robinmonsere/GIP_RM_2020-2021/GIP_RM_Documentatie/GIP presentation.pptx

## GIP presentation

The pinball machine by Robin monsere

## 2 parts

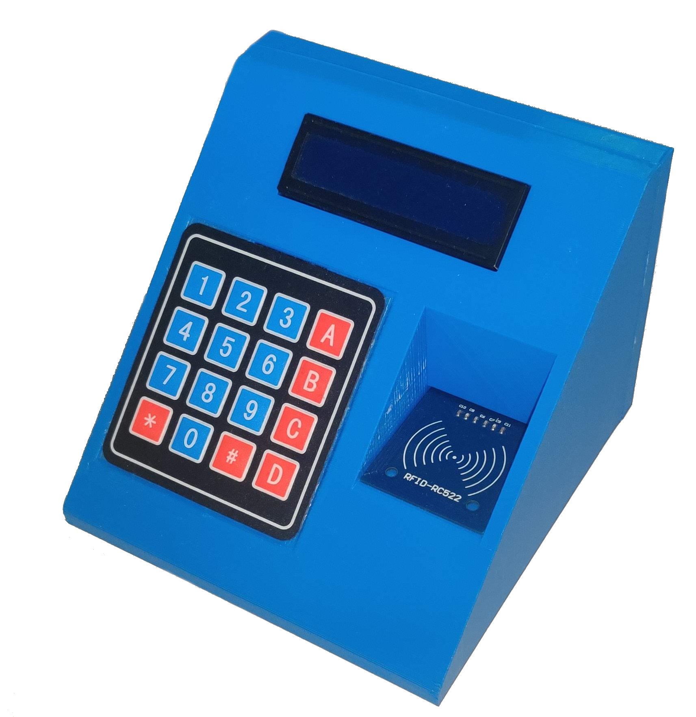
[picture p31: figure]

## No external partner/company

- Had a lot of ideas
- Has electronics/software/moving parts
- Wanted to learn RFID

## How? – 3D printing

- Sketches
- 3D drawing
- Printing

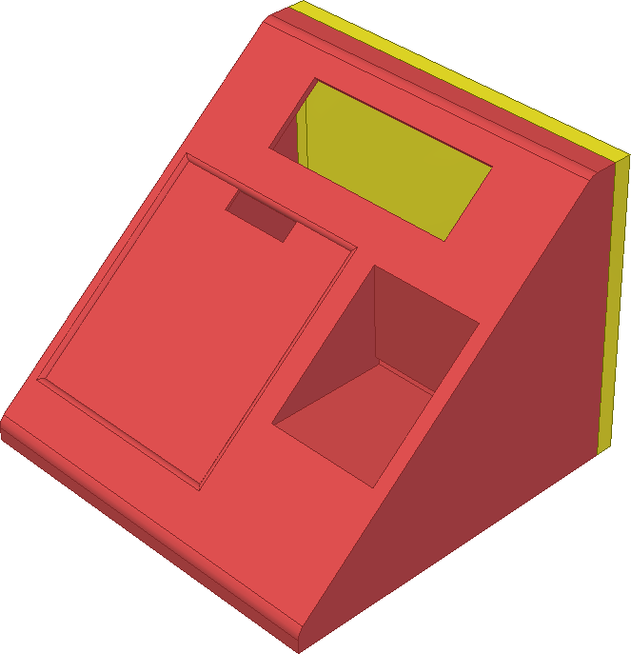
[picture p32: figure]
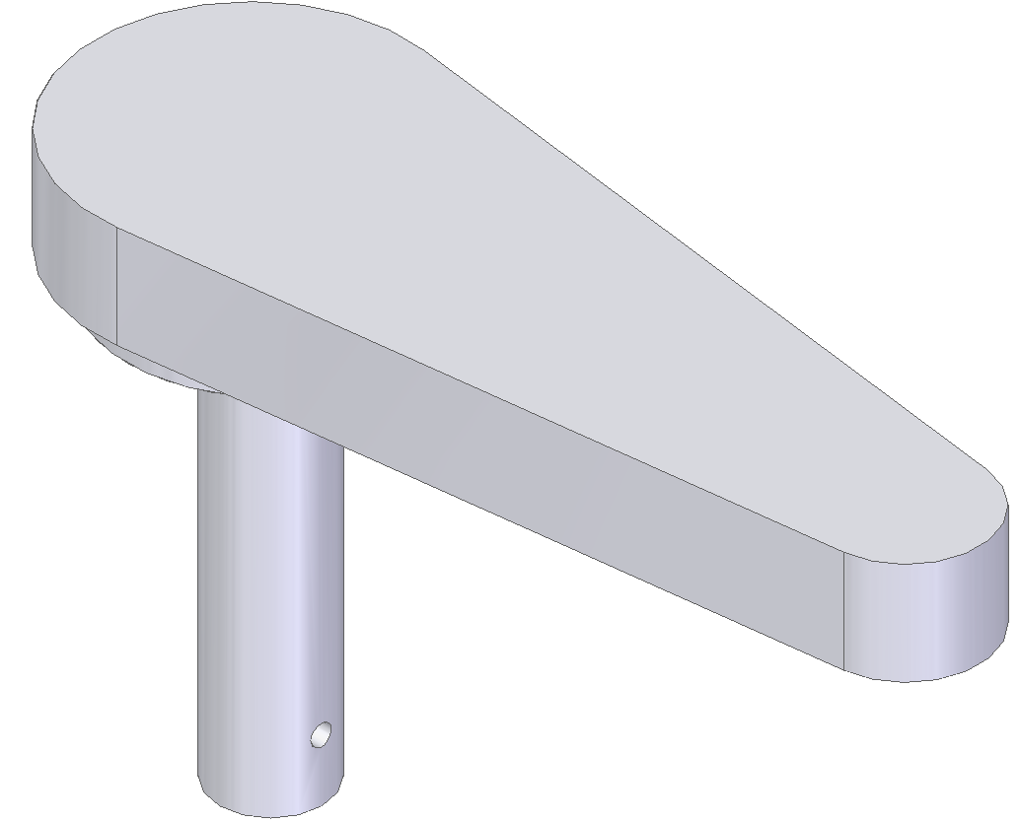
[picture p33: figure]
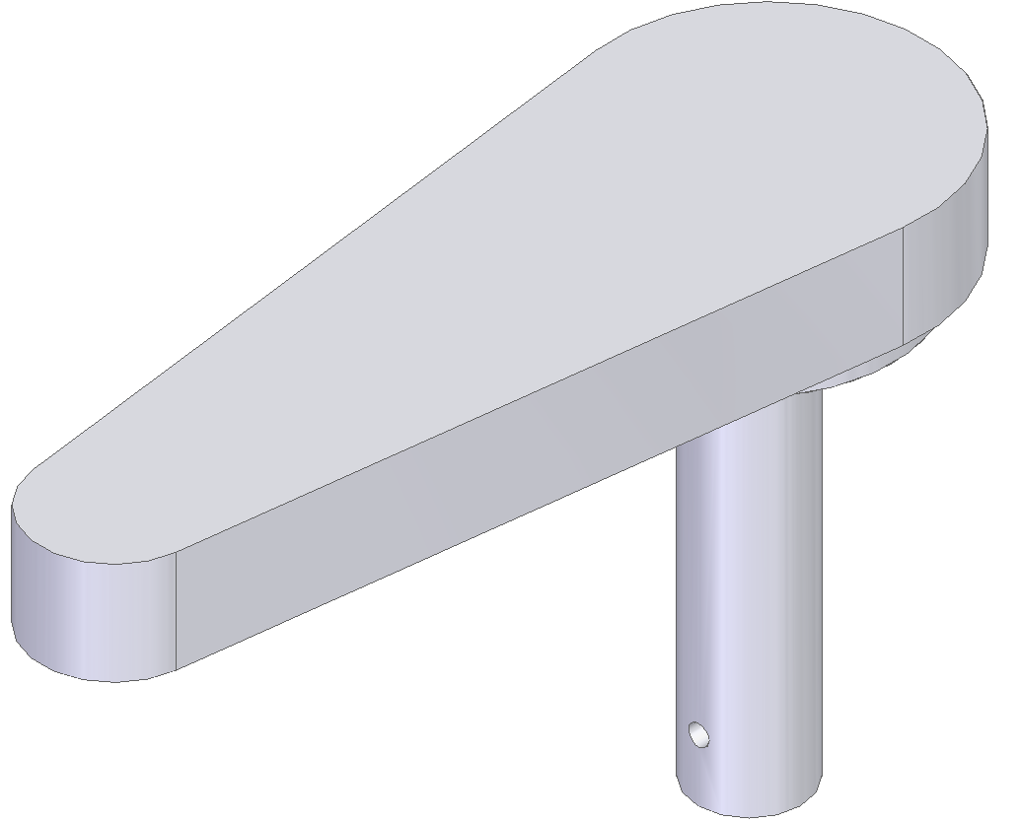
[picture p34: figure]

## How? – Electronics

- Sketches
