robinmonsere/GIP_RM_2020-2021/GIP_RM_Documentatie/GIP_RM_Portfolio9-04-2021.pdf

## Flipperkast met betaalmodule

6

## e jaar Elektriciteit-elektronica

## Schooljaar 2020-2021

## Robin Monseré

## Begeleiders: Dhr. K. Hertens

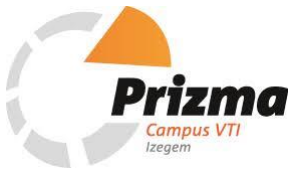
[picture p35: figure]

i

# Voorwoord

ï

ï

ii

# Abstractum

## iii

# Inhoudsopgave

1 | Inleiding | 1
2 | Betaalmodule | 2
2.1 | Werking | 3
2.2 | Toetsenbord | 4
2.2.1 | Werking | 4
2.2.2 | Aansluitingen | 6
2.2.3 | Programma | 6
Bibliotheek | 6
Declareren | 6
keypad.getkey() | 7
keypad.waitForKey() | 8
2.3 | RFID sensor module | 9
2.3.1 | werking | 9
2.3.2 | Aansluitingen | 10
2.3.3 | SPI bus | 11
2.3.4 | RFID badge | 11
Geheugen | 12
2.3.5 | Programma | 13
2.4 | I2C-LCD | 15
2.4.1 | Werking | 15
2.4.2 | Aansluiting | 15
2.5 | Programma | 16
2.5.1 | Diagram | 16
2.5.2 | Uitleg | 17
2.6 | Omhulsel | 23

iv

# 1 Inleiding

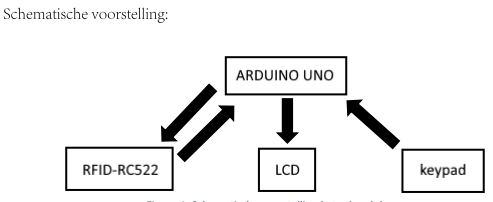
[picture p36: figure]

Figuur 1. Schematische voorstelling betaalmodule.

# 2 Betaalmodule

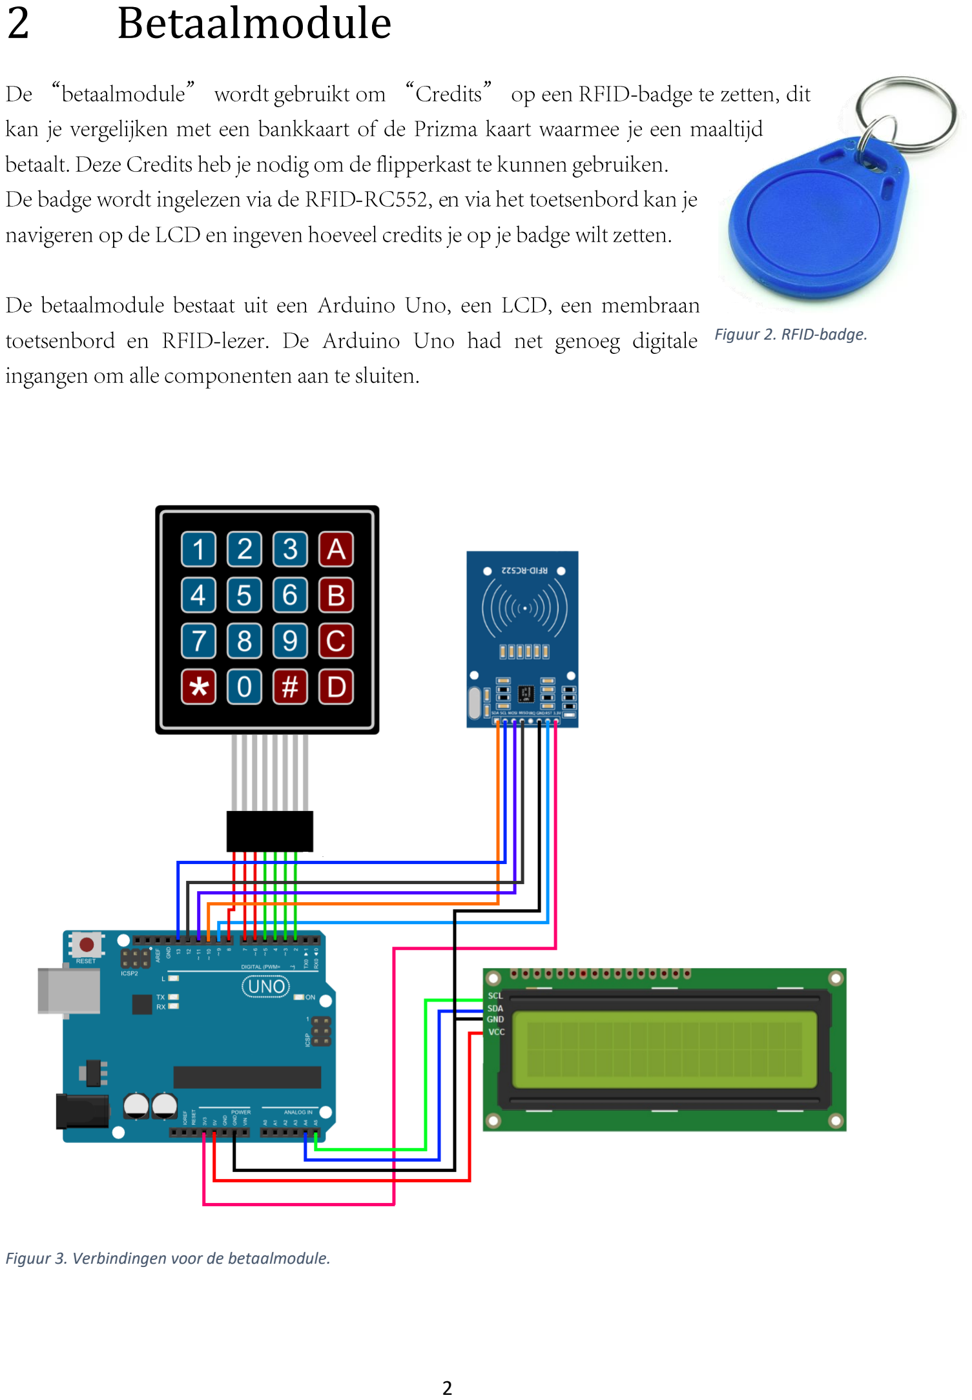
[picture p37: page 8]

Figuur 2. RFID-badge.

Figuur 3. Verbindingen voor de betaalmodule.

# 2.1 Werking

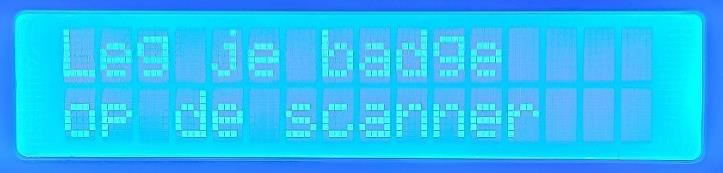
[picture p38: figure]
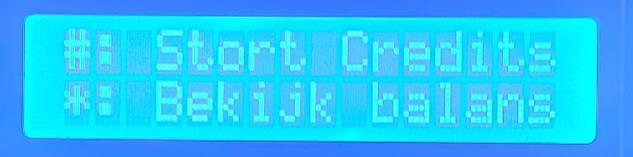
[picture p39: figure]

Figuur 4. LCD, keuzemenu. Figuur 5. LCD, passieve toestand.

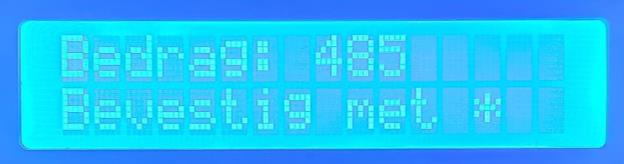
[picture p40: figure]
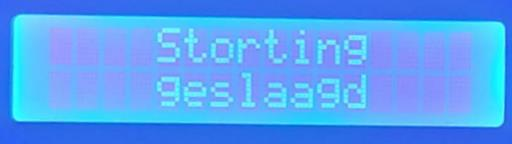
[picture p41: figure]

Figuur 7. LCD, storting geslaagd. Figuur 6. LCD, storting.

# 2.2 Toetsenbord

# 2.2.1 Werking

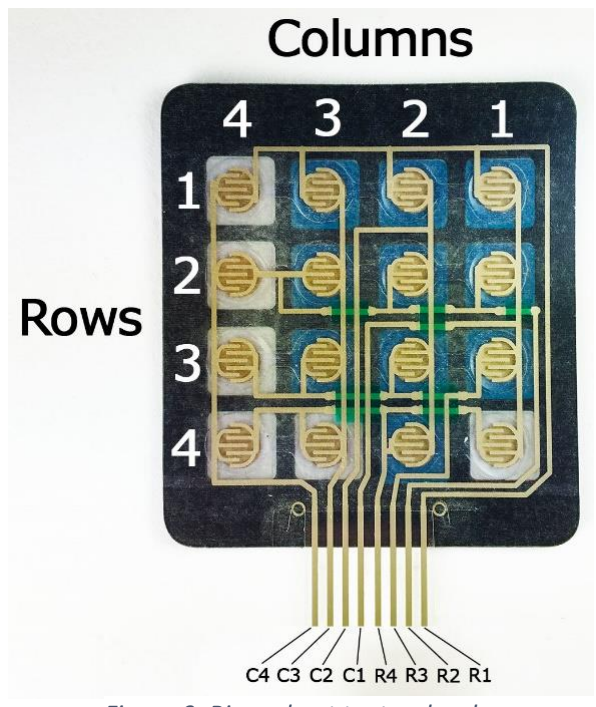
[picture p42: figure]
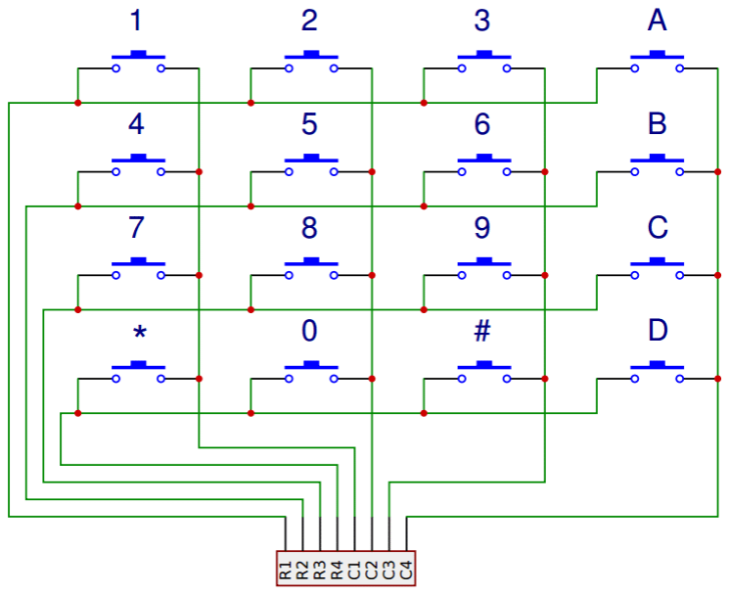
[picture p43: figure]

Figuur 8. Schema toetsenbord. | Figuur 9. Binnenkant toetsenbord.

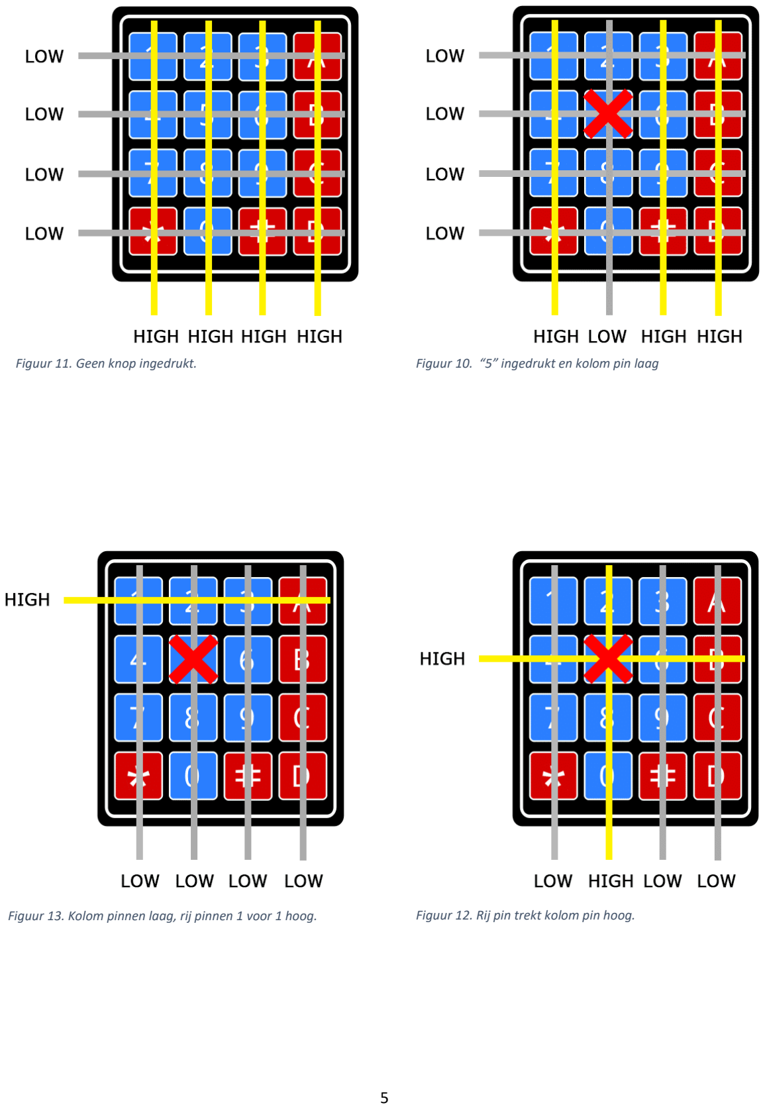
[picture p44: page 11]

Figuur 11. Geen knop ingedrukt. | Figuur 10. “5” ingedrukt en kolom pin laag
Figuur 13. Kolom pinnen laag, rij pinnen 1 voor 1 hoog. | Figuur 12. Rij pin trekt kolom pin hoog.

# 2.2.2 Aansluitingen

# 2.2.3 Programma

# Bibliotheek

# Declareren

const int ROW_NUM = 4;
const int COLUMN_NUM = 3;
char keys[ROW_NUM][COLUMN_NUM] = {
{'1', '2', '3'},
{'4', '5', '6'},
{'7', '8', '9'},
{'*', '0', '#'}
};

byte pin_rows[ROW_NUM] = {8, 7, 6, 5}; // de rijen van het keyboard byte pin_column[COLUMN_NUM] = {4, 3, 2}; // de kolommen van het keyboard Keypad keypad = Keypad(makeKeymap(keys), pin_rows, pin_column, ROW_NUM, COLUMN_NUM );

# keypad.getkey()

char keypressed = keypad.getKey(); if (keypressed == '#')
{
KeuzeMenu = false;
STORT();
}
else if (keypressed == '*') // * voor naar balans menu te gaan. {
KeuzeMenu = false;
BALANS();
}
else if (keypressed != NO_KEY) {
lcd.clear();
lcd.setCursor(0, 0);
lcd.print(F("Druk op # of *")); delay(1000);
lcd.clear();
lcd.print(F("#: Stort Credits")); lcd.setCursor(0, 1);
lcd.print(F("*: Bekijk balans")); }

# keypad.waitForKey()

char KeyPressed = ' ';
while (KeyPressed != '#')
{
KeyPressed = keypad.waitForKey(); }
KeuzeMenu = true;
KEUZEMENU();

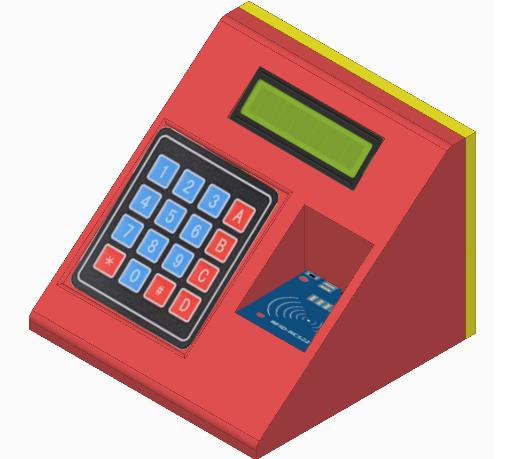
[picture p45: figure]
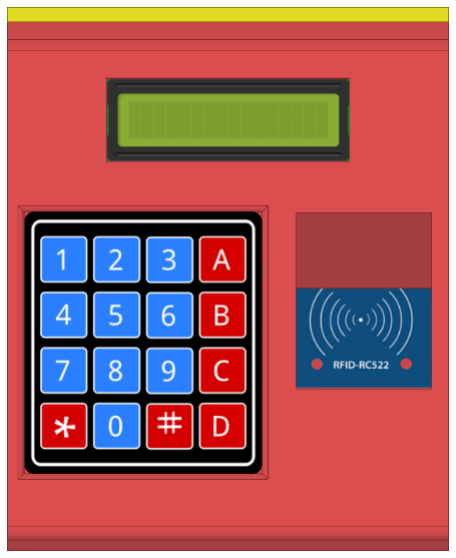
[picture p46: figure]

# 2.3 RFID sensor module

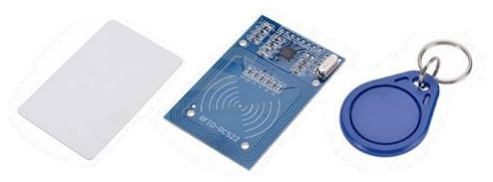
[picture p47: figure]

# 2.3.1 werking

Figuur 14. Een volledige RFID-RC522 kit met kaard en badge.

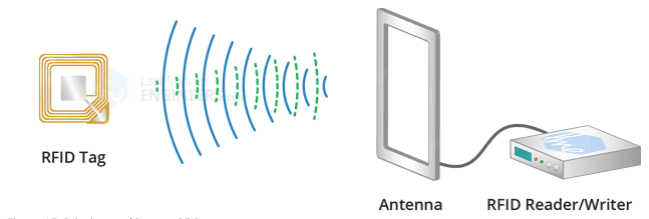
[picture p48: figure]

Figuur 15. Principe werking van RFID.

# 2.3.2 Aansluitingen

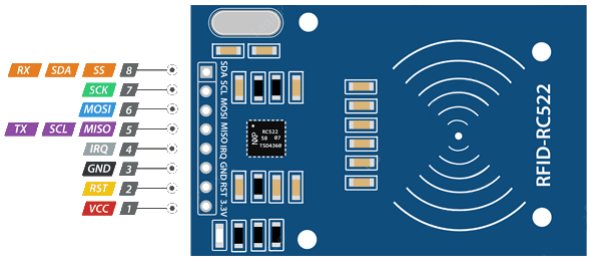
[picture p49: figure]

Figuur 16. Aansluitingen RC522

# 2.3.3 SPI bus

•
•
- ë
•

# 2.3.4 RFID badge

ë

Figuur 17. Schematische voorstelling SPI bus.

Figuur 18. Gegevens RFID-badge.

# Geheugen

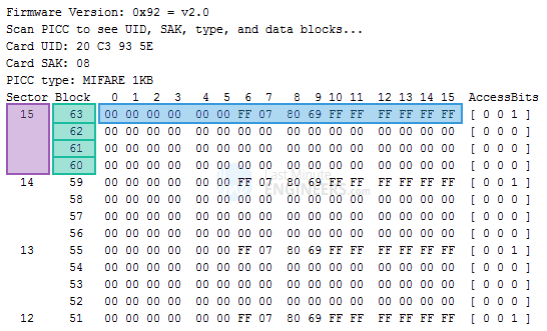
[picture p50: figure]

Figuur 19. Geheugen RFID-badge.

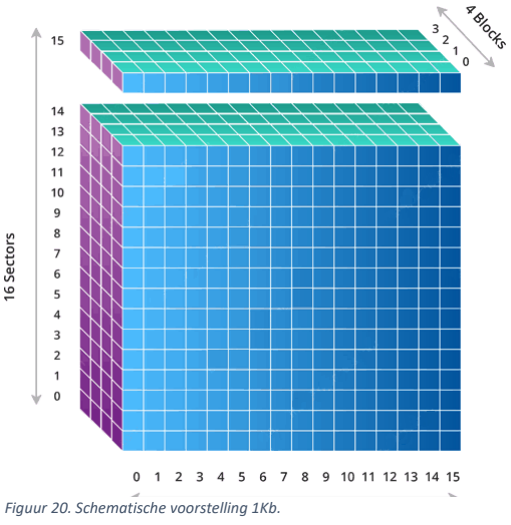
[picture p51: figure]

Figuur 20. Schematische voorstelling 1Kb.

# 2.3.5 Programma

MFRC522 mfrc522(10, 9);

ï

while (KeuzeMenu == true)
{
MFRC522::StatusCode status;
MFRC522::MIFARE_Key key;
for (byte i = 0; i < 6; i++) key.keyByte[i] = 0xFF;
status = mfrc522.PCD_Authenticate(MFRC522::PICC_CMD_MF_AUTH_KEY_A, Block, &key, &(mfrc522.uid));

if (status != MFRC522::STATUS_OK) { Serial.print(F("Authentication failed: ")); Serial.println(mfrc522.GetStatusCodeName(status)); CorrectRFID = false;
RFIDSCAN();
}

String AllPlayers[13] = {"Admin" , "Blauw" , … , "Wit"};
String UIDtags[13] = {" 23 AA E9 1B" , " 5D 68 BD 02",…, " D7 4B 21 03"};

void RFIDSCAN()
{
Serial.println(F("Nu in Void RFIDSCAN")); lcd.clear();
lcd.setCursor(0, 0);
//////////"----------------") lcd.print(F("Leg je badge")); lcd.setCursor(0, 1);
lcd.print(F("op de scanner"));
bool Card = false;
while (Card == false) {
if (mfrc522.PICC_IsNewCardPresent()) { if (mfrc522.PICC_ReadCardSerial()) { Card = true;
}
}
}
while (CorrectRFID == false) {
tag = "";
Serial.println(tag);
for (byte i = 0; i < mfrc522.uid.size; i++)
{
tag.concat(String(mfrc522.uid.uidByte[i] < 0x10 ? " 0" : " ")); tag.concat(String(mfrc522.uid.uidByte[i], HEX));
}
tag.toUpperCase();
Serial.println(tag);
for (byte i = 0; i < 12; i++)
{
if (tag == UIDtags[i]) | // Als 1 van de UIDtags gelijk
{
CurrentPlayer = AllPlayers[i]; | // is aan de ingelezen tag
CorrectRFID = true; | // Zet CorrectRFID true
lcd.clear(); | // En verwelkom de speler.
lcd.print(F("Welkom "));
lcd.print(CurrentPlayer);
Is_Ingelezen = false;
delay(500);
KeuzeMenu = true; | // Zo geraakt het progamma
KEUZEMENU(); | // | in KEUZEMENU()
}
}
if (CorrectRFID == false)
{
Serial.println(F("Deze tag zit niet in de databasis")); lcd.clear();
lcd.print(F("Afgewezen"));
delay(500);
return;
}
}
}

2.4 | I2C-LCD
2.4.1 | Werking

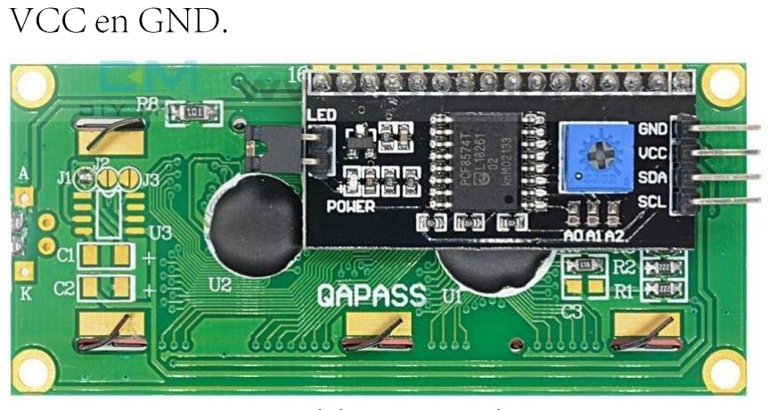
[picture p52: figure]

2.4.2 | Aansluiting

Figuur 21. LCD met I2C module gemonteerd.

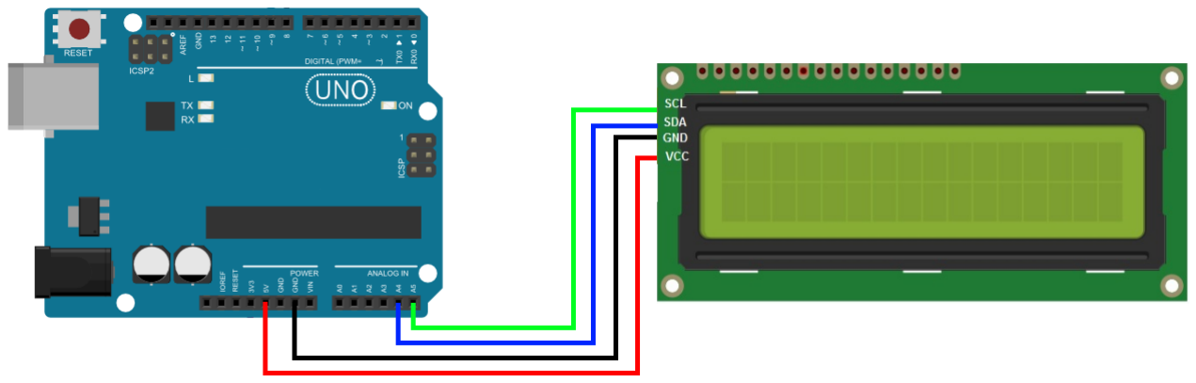
[picture p53: figure]

Figuur 22. Aansluitingen voor LCD.

# 2.5 Programma

# 2.5.1 Diagram


# 2.5.2 Uitleg

ë
ï
ë

void loop()
{
Serial.println(F("Nu in Void Loop")); if (CorrectRFID == false) RFIDSCAN(); if (CorrectRFID == true) KEUZEMENU(); }

void RFIDSCAN()
{
Serial.println(F("Nu in Void RFIDSCAN")); lcd.clear();
lcd.setCursor(0, 0);
lcd.print(F("Leg je badge"));
lcd.setCursor(0, 1);
lcd.print(F("op de scanner"));
bool Card = false; | // lokale var voor check of er een kaard
while (Card == false) { | // aanwezig is, dit houd de code tegen
if (mfrc522.PICC_IsNewCardPresent()) { | // als er geen badge op
if (mfrc522.PICC_ReadCardSerial()) { | // de scanner ligt.
Card = true; | // Zo wordt niet heel de | RFIDSCAN()
} | // doorlopen. Dit bakje staat dan
} | // ook vaak inactief.
}

while (CorrectRFID == false) {
tag = "";
Serial.println(tag);
for (byte i = 0; i < mfrc522.uid.size; i++)
{
tag.concat(String(mfrc522.uid.uidByte[i] < 0x10 ? " 0" : " ")); tag.concat(String(mfrc522.uid.uidByte[i], HEX));
}
tag.toUpperCase();
Serial.println(tag);
for (byte i = 0; i < 12; i++)
{
if (tag == UIDtags[i]) | // Als 1 van de UIDtags gelijk
{
CurrentPlayer = AllPlayers[i]; | // is aan de ingelezen tag
CorrectRFID = true; | // Zet CorrectRFID true
lcd.clear(); | // En verwelkom de speler.
lcd.print(F("Welkom "));
lcd.print(CurrentPlayer);
Is_Ingelezen = false;
delay(500);
KeuzeMenu = true; | // Zo geraakt het progamma in
KEUZEMENU(); | // KEUZEMENU()
}
}
if (CorrectRFID == false)
{
Serial.println(F("Deze tag zit niet in de databasis")); lcd.clear();
lcd.print(F("Afgewezen"));
delay(500);
return;
}
}
}

while (KeuzeMenu == true)
{
MFRC522::StatusCode status; //check of tag nog aanwezig is, zo niet,
MFRC522::MIFARE_Key key; | //zal programma terug in RFIDSCAN() gaan.
for (byte i = 0; i < 6; i++) key.keyByte[i] = 0xFF;
status = mfrc522.PCD_Authenticate(MFRC522::PICC_CMD_MF_AUTH_KEY_A, r Block, &key, &(mfrc522.uid));
if (status != MFRC522::STATUS_OK) { Serial.print(F("Authentication failed: ")); Serial.println(mfrc522.GetStatusCodeName(status)); CorrectRFID = false;
RFIDSCAN();
}

char keypressed = keypad.getKey(); if (keypressed == '#')
{
KeuzeMenu = false;
STORT();
}
else if (keypressed == '*') // * voor naar saldo menu te gaan. {
KeuzeMenu = false;
SALDO();
}
else if (keypressed != NO_KEY) {
lcd.clear();
lcd.setCursor(0, 0);
lcd.print(F("Druk op # of *")); delay(1000);
lcd.clear();
lcd.print(F("#: Stort Credits")); lcd.setCursor(0, 1);
lcd.print(F("*: Bekijk saldo")); }
}

ë

void SALDO()
{
Serial.println(F("Nu in Void SALDO"));
if (Is_Ingelezen == false) INLEZEN(false);
Serial.println(NCredits); | // Credits in,
lcd.clear();
lcd.setCursor(0, 0);
lcd.print(F("Credits: "));
lcd.print(NCredits);
lcd.setCursor(0, 2);
lcd.print(F("#: Keer terug")); char KeyPressed = ' ';
while (KeyPressed != '#')
{
// code dat controleert of er nog een badge aanwezig is. }
KeuzeMenu = true;
loop();
}

void INLEZEN(bool Stort)
{
NCredits = 0; | // Reset Credits var
Serial.println(F("Nu in Void INLEZEN"));
MFRC522::MIFARE_Key key; | // Maak key klaar
for (byte i = 0; i < 6; i++) key.keyByte[i] = 0xFF; MFRC522::StatusCode status;
status = mfrc522.PCD_Authenticate(MFRC522::PICC_CMD_MF_AUTH_KEY_A, zzBlock, &key, &(mfrc522.uid));
if (status != MFRC522::STATUS_OK) {
lcd.clear();
lcd.setCursor(5, 0);
lcd.print(F("Error 404")); Serial.print(F("Authentication failed: ")); Serial.println(mfrc522.GetStatusCodeName(status)); CorrectRFID = false;
return;
}
status = mfrc522.MIFARE_Read(Block, ReadBuffer, &BufferSize); if (status != MFRC522::STATUS_OK) {
lcd.clear();
lcd.setCursor(5, 0);
lcd.print(F("Error 400")); Serial.print(F("Reading failed: ")); Serial.println(mfrc522.GetStatusCodeName(status)); CorrectRFID = false;
return;
}
Is_Ingelezen = true; | // Hierdoor lees je maar 1 keer in
for (byte i = 0; i < 16; i++) {
if (ReadBuffer[i] != 32) {
Serial.println(ReadBuffer[i]);
NCredits = NCredits + ReadBuffer[i];
}
}
memset(ReadBuffer, 0, sizeof(ReadBuffer)); // zet de buffer terug leeg
Serial.print("Bool Stort = "); | // voor volgende keer.
Serial.println(Stort);
if (Stort == false) SALDO();
if (Stort == true) STORT();
}

void STORT()
{
Serial.println(F("Nu in Void STORT"));
if (Is_Ingelezen == false) INLEZEN(true); memset(WriteBuffer, 0, sizeof(WriteBuffer)); lcd.clear();
lcd.setCursor(0, 0);
lcd.print(F("Bedrag: "));
lcd.setCursor(0, 1);
lcd.print(F("Bevestig met *"));
char PressedKeys[3] = {""};
byte n = 0;
bool AsteriskPressed = false; | // check voor '*',
while ( AsteriskPressed == false) { | // bevestig de storting.
char PressedKey = ' ';
PressedKey = keypad.waitForKey();
if (PressedKey == '*') {
AsteriskPressed = true;
}
else if (n < 3 && PressedKey != '#') {
PressedKeys[n] = PressedKey; Serial.println(PressedKeys[n]); lcd.setCursor(8 + n, 0);
lcd.print(PressedKey);
n = n + 1;
}
}
if (n == 0)
{
lcd.clear();
lcd.print(F(" | Annuleren? | "));
lcd.setCursor(0, 1);
lcd.print(F(" | Druk # | "));
char KeyPressed = ' ';
while (KeyPressed != '#') { KeyPressed = keypad.waitForKey(); }
KeuzeMenu = true;
KEUZEMENU();
}
NCredits = NCredits + atoi(&PressedKeys[0]); //bereken totaal credits bool bevestigd = false;
while (bevestigd == false) {
lcd.clear(); | // Nog éénmaal bevestigen.
lcd.print(F("Saldo:"));
lcd.setCursor(7, 0);
lcd.print(NCredits);

lcd.setCursor(0, 1);
lcd.print(F("Bevestig met *")); char KeyPressed = ' ';
KeyPressed = keypad.waitForKey(); if (KeyPressed != '*')
{
lcd.clear();
lcd.print(F(" | Annuleren? | "));
lcd.setCursor(0, 1);
lcd.print(F(" | Druk # | "));
char KeyPressed = ' ';
KeyPressed = keypad.waitForKey(); delay(100);
if (KeyPressed == '#')
{
Is_Ingelezen = false;
KeuzeMenu = true;
KEUZEMENU();
}
}
else if (KeyPressed == '*') {
bevestigd = true;
}
}

Is_Ingelezen = false;

for (byte i; i < 16; i++)
{
if (NCredits > 255) {
WriteBuffer[i] = 255;
NCredits = NCredits - 255; }
else if (NCredits < 255)
{
WriteBuffer[i] = NCredits; NCredits = 0;
}
else if (NCredits = 0)
{
WriteBuffer[i] = 0;
}
}

// hier komt code die key klaarmaakt en controleert of de badge klaar // is om data te ontvangen. Bij een error, ga terug naar RFIDSCAN

status = mfrc522.MIFARE_Write(Block, WriteBuffer, 16);
// code die bij een error dit aangeeft op de LCD/seriele monitor if (status == MFRC522::STATUS_OK) {
lcd.clear();
lcd.setCursor(4, 0);
lcd.print(F("Storting"));
lcd.setCursor(4, 1);
lcd.print(F("geslaagd"));
delay(2000);
KeuzeMenu = true;
KEUZEMENU();
}
}

# 2.6Omhulsel

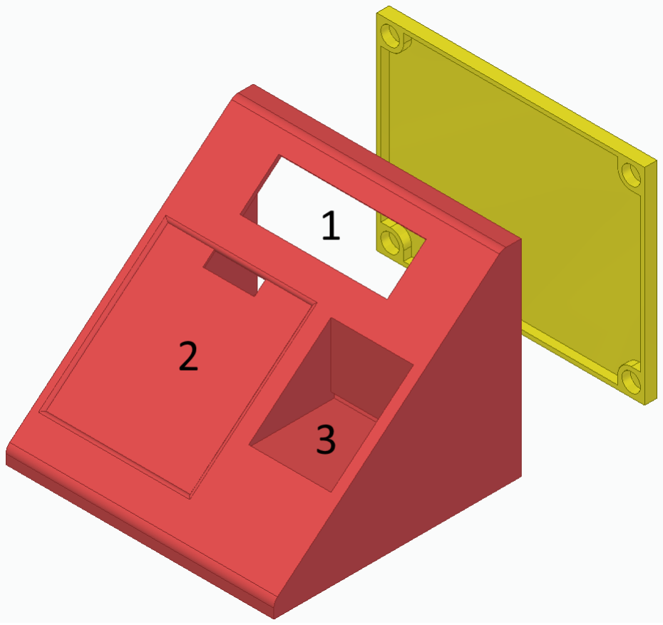
[picture p54: figure]

Figuur 23. Solid Edge assembly tekening .

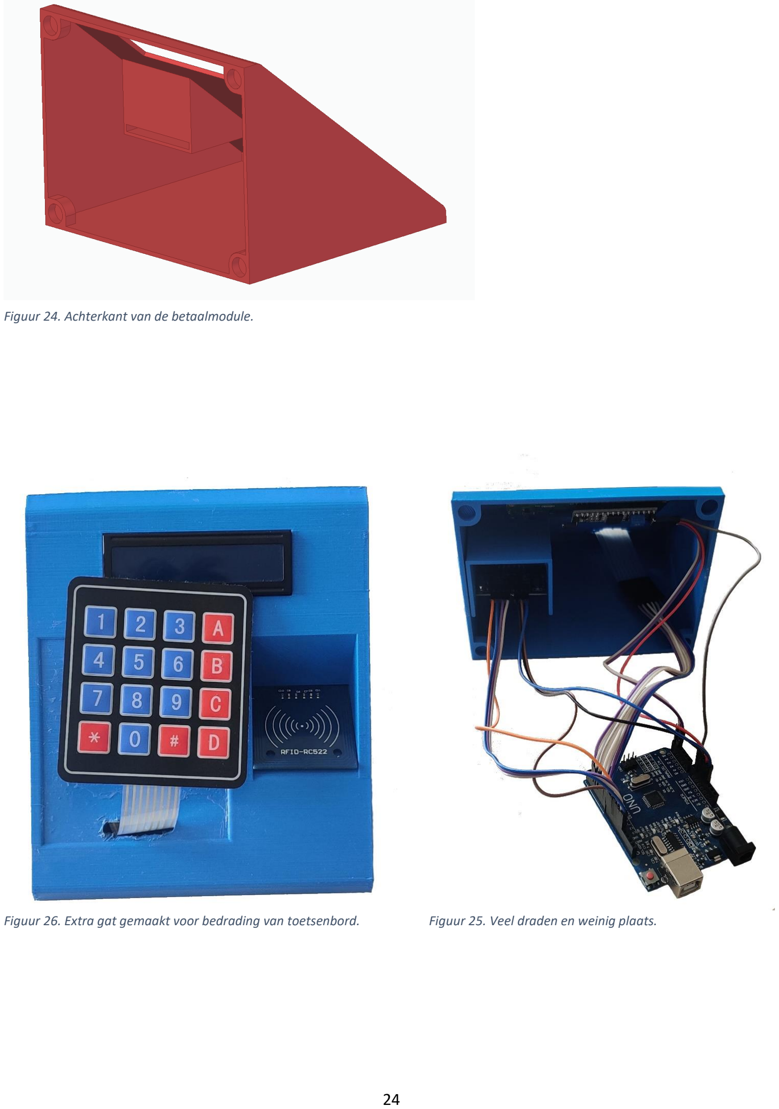
[picture p55: page 30]

Figuur 24. Achterkant van de betaalmodule.

Figuur 26. Extra gat gemaakt voor bedrading van toetsenbord. | Figuur 25. Veel draden en weinig plaats.

# 2.7 Tussenbesluit

ë

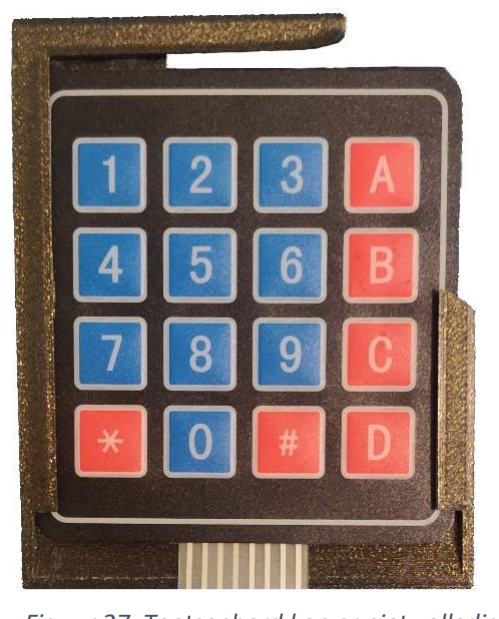
[picture p56: figure]
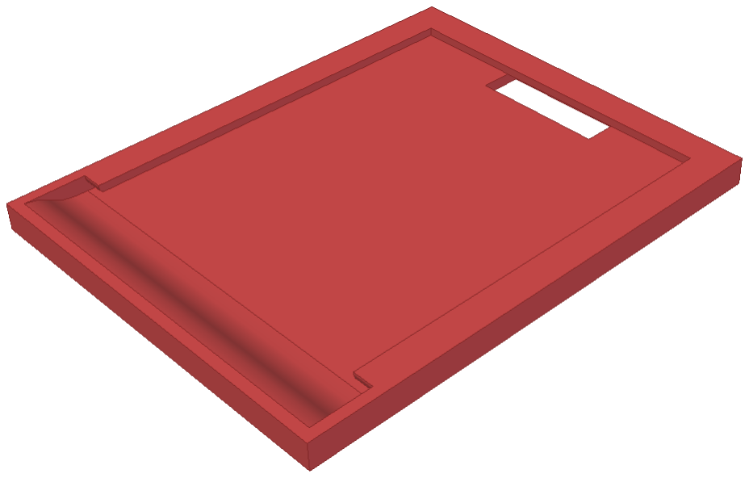
[picture p57: figure]

Figuur 28. Solid edge tekening voor toetsenbord case. | Figuur 27. Toetsenbord kon er niet volledig in.
