robinmonsere/GIP_RM_2020-2021/GIP_RM_Documentatie/schemas/GIP_RM_FlipperkastLayout.png

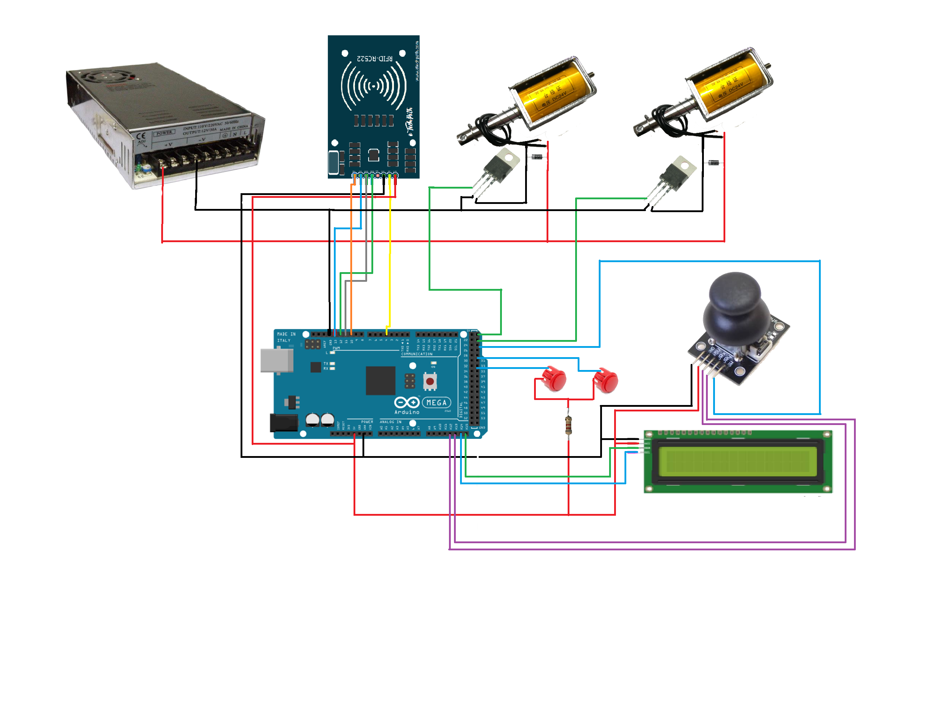
GIP_RM_Documentatie/schemas/GIP_RM_FlipperkastLayout.png
