robinmonsere/GIP_RM_2020-2021/GIP_RM_Documentatie/schemas/LCD+joystick.png

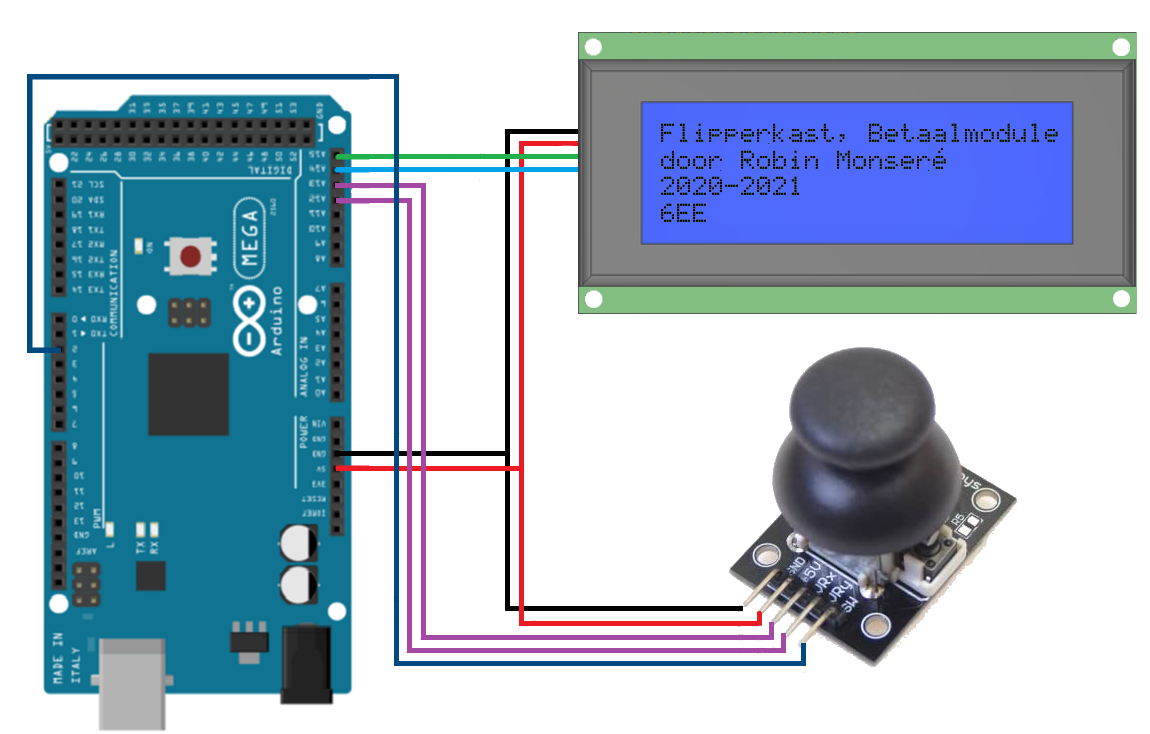
GIP_RM_Documentatie/schemas/LCD+joystick.png
