robinmonsere/GIP_RM_2020-2021/GIP_RM_Documentatie/schemas/Schema buttonsV2WIT.png

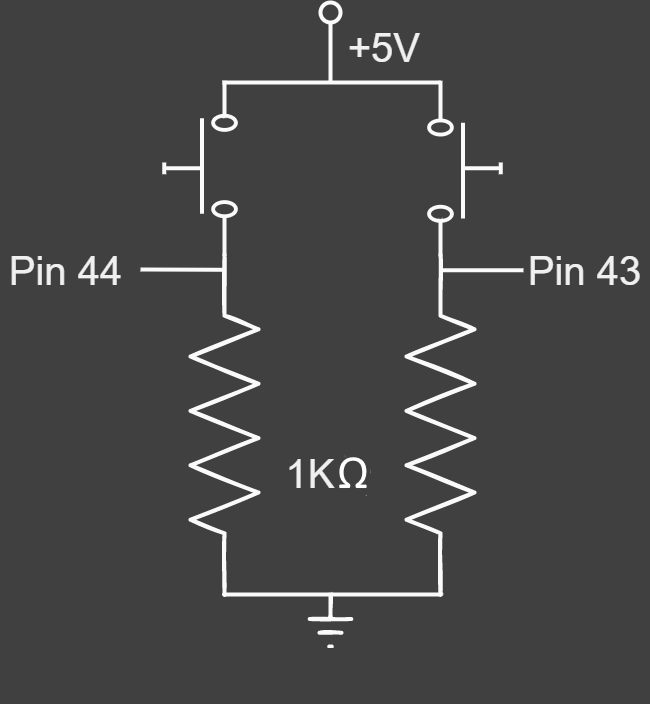
GIP_RM_Documentatie/schemas/Schema buttonsV2WIT.png
