robinmonsere/GIP_RM_2020-2021/GIP_RM_Documentatie/schemas/Software Schema Betaalmodule Zwart.png

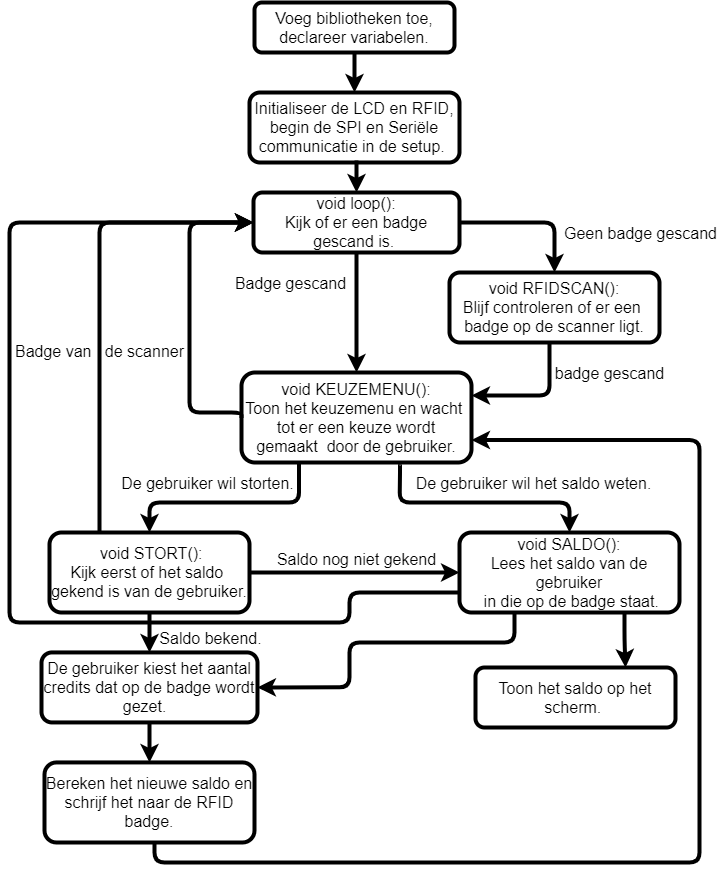
GIP_RM_Documentatie/schemas/Software Schema Betaalmodule Zwart.png
