robinmonsere/GIP_RM_2020-2021/GIP_RM_Documentatie/schemas/stuurkringSolanoidWITV3.png

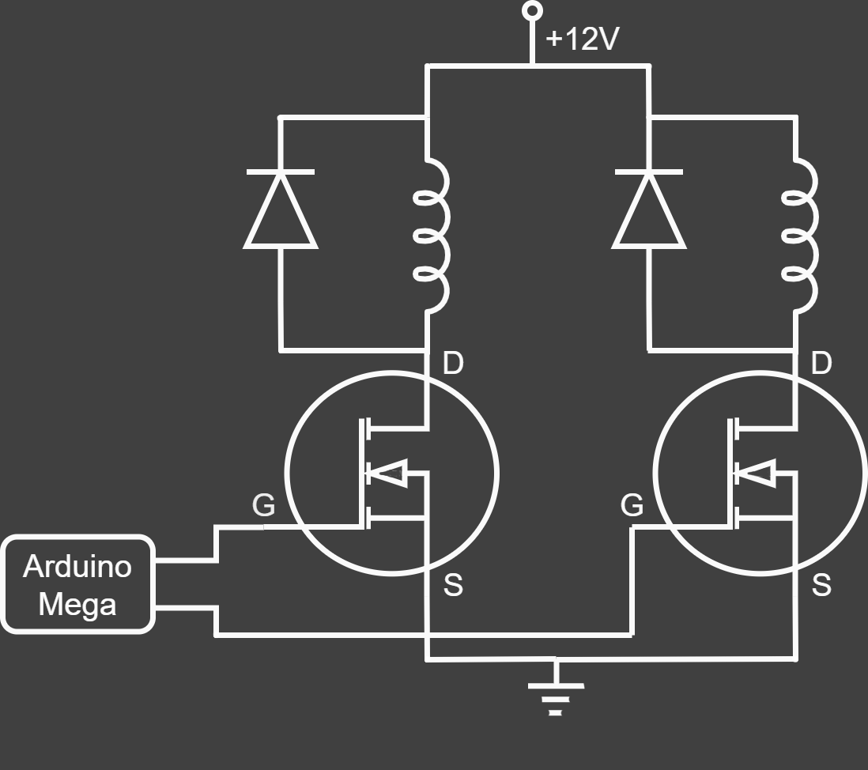
GIP_RM_Documentatie/schemas/stuurkringSolanoidWITV3.png
