robinmonsere/GIP_RM_2020-2021/GIP_RM_Documentatie/schemas/Webp.net-gifmaker (2).gif

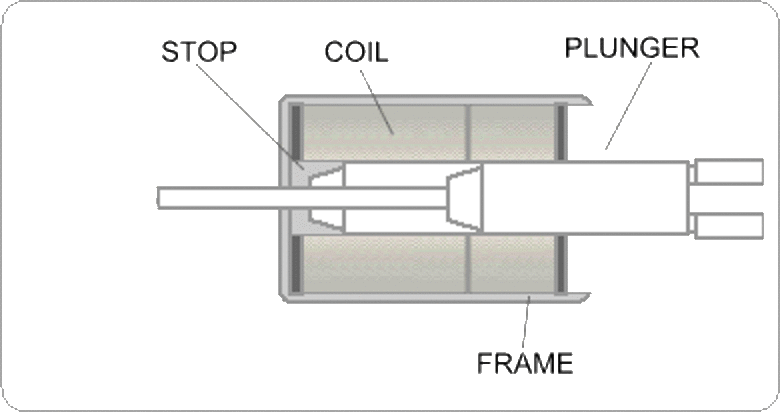
GIP_RM_Documentatie/schemas/Webp.net-gifmaker (2).gif
