robinmonsere/GIP_RM_2020-2021/GIP_RM_SolidEdge/GIP_RM_Betaalmodule/GIP_RM_FbetaalmoduleAchterkant.stl

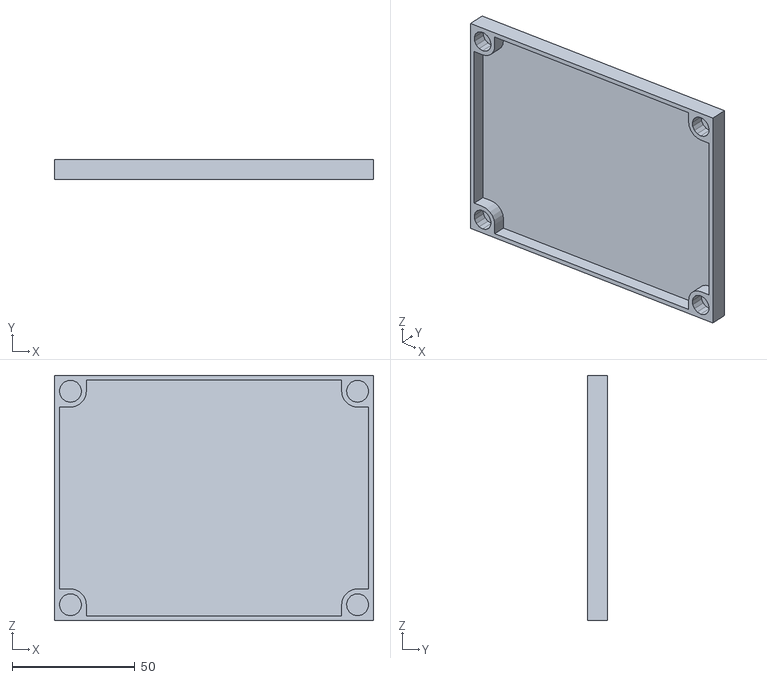
[picture p82: CAD file, 2021-04-12]
GIP_RM_SolidEdge/GIP_RM_Betaalmodule/GIP_RM_FbetaalmoduleAchterkant.stl
130.0 x 8.00 x 100.0
