robinmonsere/GIP_RM_2020-2021/GIP_RM_SolidEdge/STL/Opvangstukje.stl

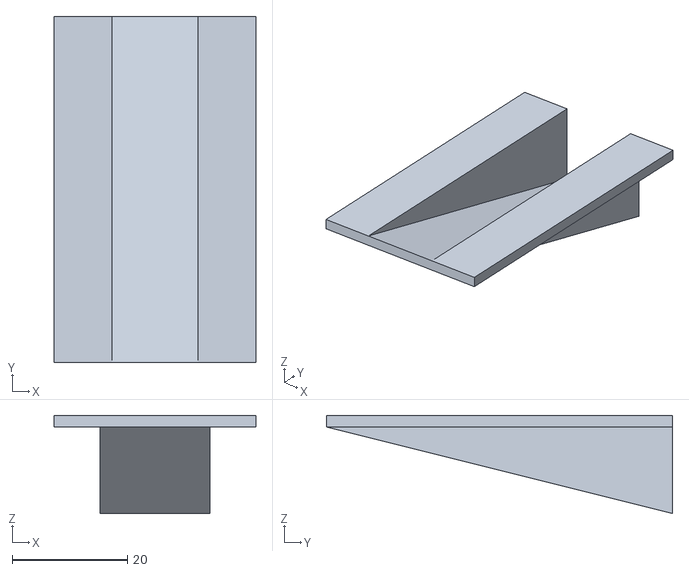
[picture p83: CAD file, 2021-04-21]
GIP_RM_SolidEdge/STL/Opvangstukje.stl
35.0 x 60.0 x 17.0
