robinmonsere/GIP_RM_2020-2021/GIP_RM_SolidEdge/STL/flipperV2.stl

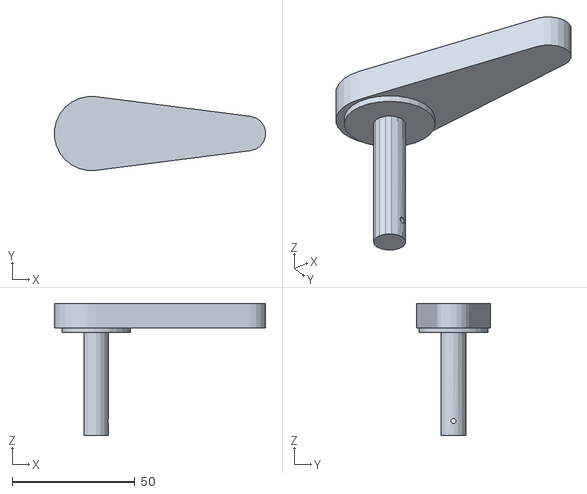
[picture p84: CAD file, 2021-04-21]
GIP_RM_SolidEdge/STL/flipperV2.stl
86.0 x 30.1 x 54.0
