robinmonsere/GIP_RM_2020-2021/GIP_RM_SolidEdge/STL/VerbindingMotor.stl

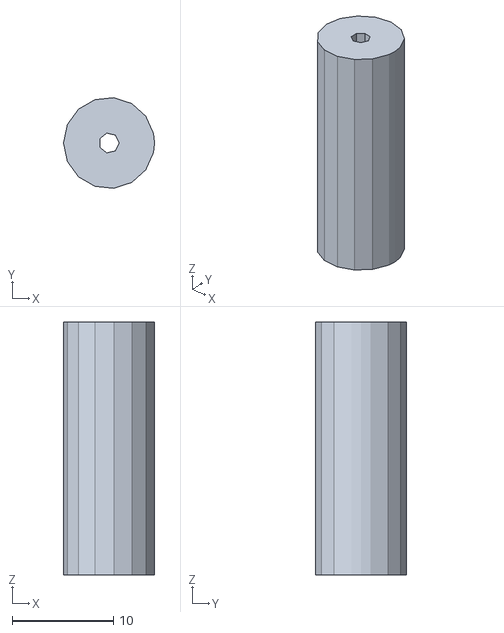
[picture p85: CAD file, 2021-04-06]
GIP_RM_SolidEdge/STL/VerbindingMotor.stl
9.00 x 8.95 x 25.0
