robinmonsere/GIP_RM_2020-2021/GIP_RM_SolidEdge/STL/GIP_RM_FbetaalmoduleAchterkant.stl

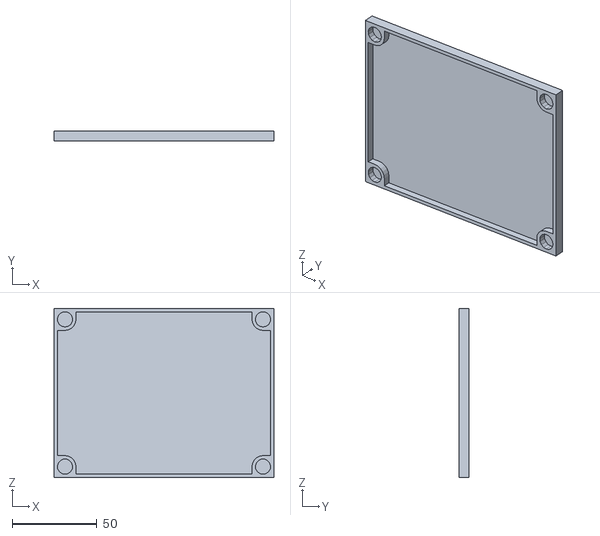
[picture p86: CAD file, 2021-01-28]
GIP_RM_SolidEdge/STL/GIP_RM_FbetaalmoduleAchterkant.stl
130.0 x 6.00 x 100.0
