robinmonsere/GIP_RM_2020-2021/GIP_RM_SolidEdge/STL/GIP_RM_LCD_Test.stl

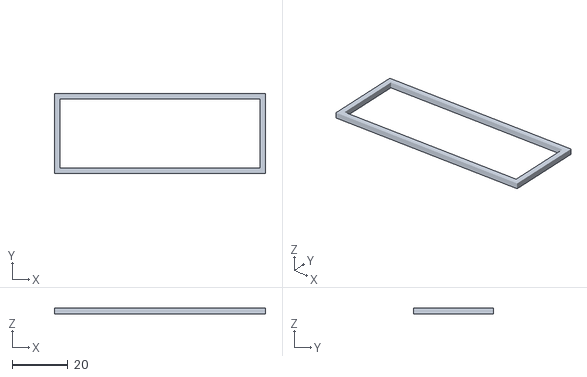
[picture p87: CAD file, 2021-01-28]
GIP_RM_SolidEdge/STL/GIP_RM_LCD_Test.stl
75.5 x 28.7 x 2.00
