robinmonsere/GIP_RM_2020-2021/GIP_RM_SolidEdge/STL/RFID Bakje.stl

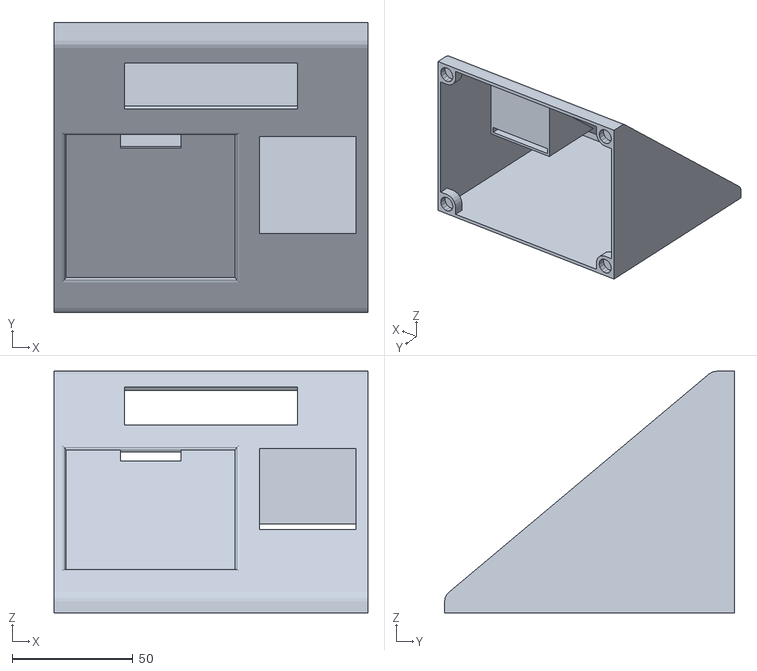
[picture p88: CAD file, 2021-01-28]
GIP_RM_SolidEdge/STL/RFID Bakje.stl
130.0 x 120.0 x 100.0
