robinmonsere/GIP_RM_2020-2021/GIP_RM_SolidEdge/STL/GIP_RM_FBetaalModule.stl

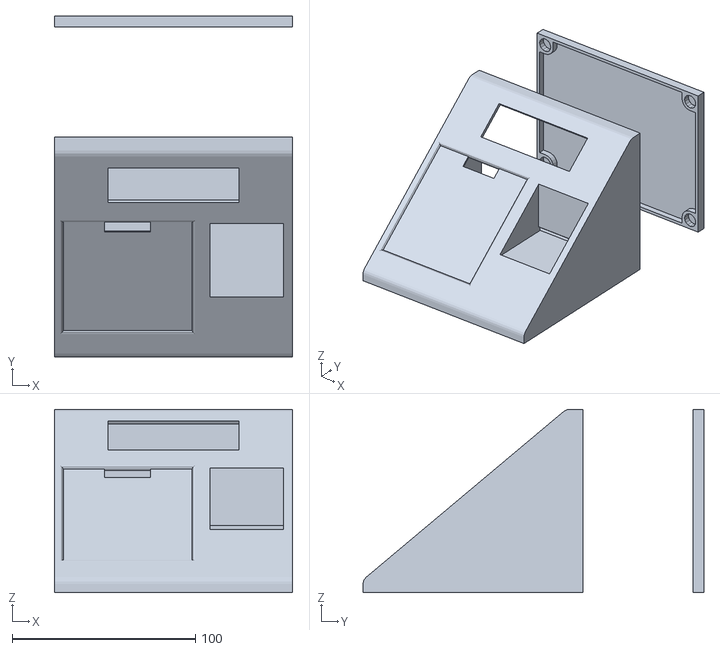
[picture p89: CAD file, 2021-01-28]
GIP_RM_SolidEdge/STL/GIP_RM_FBetaalModule.stl
130.0 x 185.9 x 100.0
