robinmonsere/GIP_RM_2020-2021/GIP_RM_SolidEdge/STL/GIP_RM_KeypadMini.stl

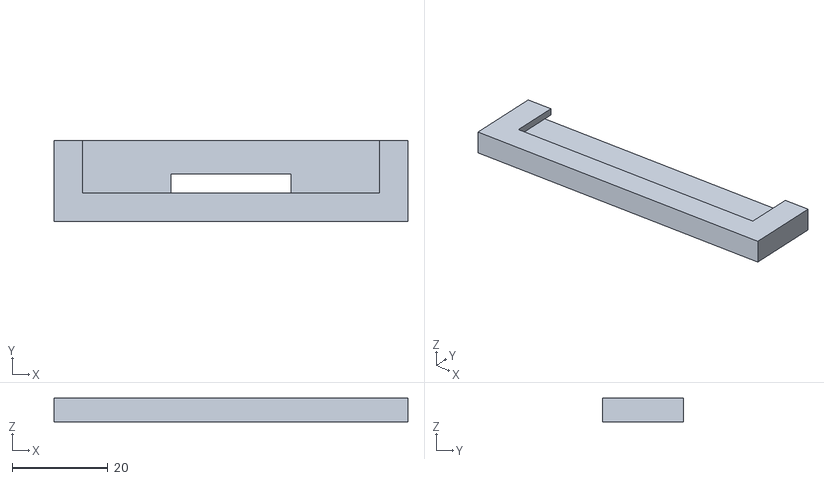
[picture p90: CAD file, 2020-10-07]
GIP_RM_SolidEdge/STL/GIP_RM_KeypadMini.stl
74.0 x 17.0 x 5.00
