robinmonsere/GIP_RM_2020-2021/GIP_RM_SolidEdge/STL/RFID Bakje Keypad STL.stl

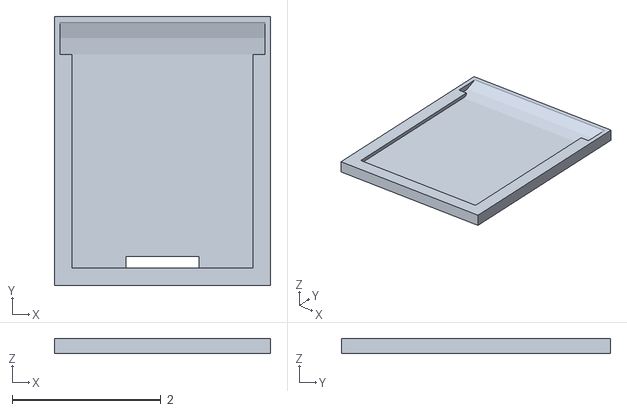
[picture p91: CAD file, 2020-10-05]
GIP_RM_SolidEdge/STL/RFID Bakje Keypad STL.stl
2.91 x 3.62 x 0.197
