robinmonsere/GIP_RM_2020-2021/GIP_RM_SolidEdge/STL/flipper.stl

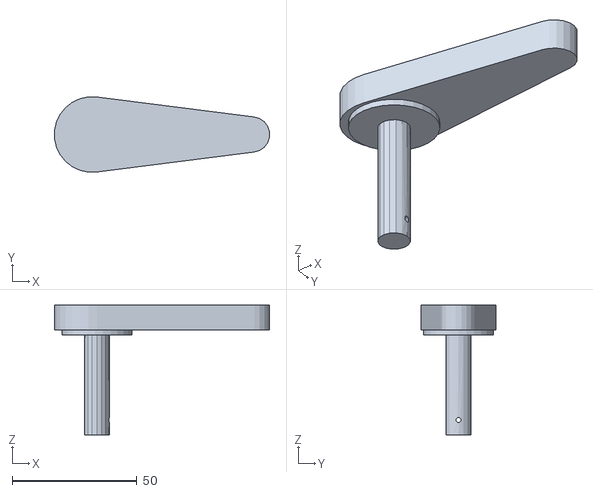
[picture p92: CAD file, 2021-04-06, an earlier design]
GIP_RM_SolidEdge/STL/flipper.stl
86.0 x 30.1 x 52.0
