robinmonsere/GIP_RM_2020-2021/(commit log)

2020-10-05 Commiting alles
    [Logboek.xlsx, RFID Bakje Keypad STL.stl]
2020-10-05 Uploaden Arduino Code
2020-10-21 Fixed bug in Betaalmodule
    Fixed bug in Betaalmodule die te doen had met RFID card niet goed inlezen. Ook programma proper gemaakt.
    [BALANS.ino, GIP_RM_Betaalmodule.ino, INLEZEN.ino, KEUZEMENU.ino, RFIDSCAN.ino, STORT.ino]
2021-01-28 3D tekening
    [16x2_back_45deg_m2.prt, 16x2_back_45deg_m2.stl, 16x2_back_45deg_m3.prt, 16x2_back_45deg_m3.stl, 16x2_back_90deg_m2.prt, 16x2_back_90deg_m2.stl, 16x2_back_90deg_m3.prt, 16x2_back_90deg_m3.stl]
2021-04-06 Portfolio
    Werken aan portfolio. delete verschillende STL files.
    [16x2_back_45deg_m2.prt, 16x2_back_45deg_m2.stl, 16x2_back_45deg_m3.prt, 16x2_back_45deg_m3.stl, 16x2_back_90deg_m2.prt, 16x2_back_90deg_m2.stl, 16x2_back_90deg_m3.prt, 16x2_back_90deg_m3.stl]
2021-04-08 portfolio
    kleine update (annuleren bij het storten)
    [GIP_RM_FBetaalModule.cfg]
2021-04-12 betaalmodule achterkant V2
    [GIP_RM_FbetaalmoduleAchterkant.stl]
2021-04-21 Solid edge
    Solid edge (opvangstukje)
    [Flipperkast.cfg, Opvangstukje.stl, flipperV2.stl]
2021-04-28 Code, flipperkast
    Massas updates aan flipperkast
    keuzemenu van spel
    [BATTLEROYAL.ino, Flipperen.ino, GIP_RM_Flipperkast.ino, GIP_RM_RFID.ino, KIESSPEL.ino, SALDO.ino, STORT.ino]
2021-05-30 Schema + stepper
2021-10-08 Cleaned up the mess, final commit!
    Cleaned up the mess, final commit!
    [Logboek.xlsx]
